Deivid21/horno-automatizado-esp32-flask/(commit log)

2026-11-11 feat(esp32): add pin and threshold configuration
2026-11-11 feat(esp32): add DHT22 sensor module
    Read chamber temperature and humidity every 2 s, keep the last valid
    reading and report a fault after repeated failed reads.
    [SensorDHT22.cpp, SensorDHT22.h]
2026-11-11 feat(esp32): add DS18B20 safety sensor module
    Non-blocking reads with an emergency at 70 C that rearms itself
    below 65 C. Disconnected or power-on readings count as faults.
2026-11-11 feat(esp32): add HC-SR04 presence module
    Detect an object inside the chamber within 10 cm, filtered over
    several consecutive readings.
2026-11-11 feat(esp32): add MQ-2 gas sensor module
    Average the analog reading, skip the 60 s warm-up and raise an
    emergency over the threshold with hysteresis.
    [SensorGas.cpp, SensorGas.h]
2026-11-11 feat(esp32): add non-blocking buzzer alarm patterns
    [Buzzer.cpp, Buzzer.h]
2026-11-11 feat(esp32): add fan and heater outputs
    The heater pin is reserved for the future optocoupler stage and
    stays low until CALEFACTOR_INSTALADO is enabled.
2026-11-11 feat(esp32): add 20x4 I2C LCD module
2026-11-11 feat(esp32): add main drying controller
    Combine the modules into a prioritized state machine with stand-by,
    15/30/60 min drying modes, automatic emergency rearm and a periodic
    serial report.
2026-11-11 docs(esp32): document wiring, states and serial commands
2026-11-11 chore(esp32): add license headers to source files
2026-11-11 feat(esp32): move LCD I2C to GPIO 21 (SDA) and 22 (SCL)
2026-11-11 feat(esp32): add JSON status line for the Flask server
    Send one JSON line after each serial report so the Raspberry Pi can
    parse the oven state over USB. Human-readable lines are unchanged.
2026-11-11 feat(flask): add oven monitor for state changes and drying cycles
    Parse the ESP32 JSON lines, log state transitions and track each
    cycle as complete or interrupted with its average temperature.
2026-11-11 feat(flask): add ESP32 serial connection
    Read the USB port in a background thread, reconnect on failure and
    send drying mode commands.
    [conexion.py]
2026-11-11 feat(flask): add demo simulator
    Generate ESP32-like data with an accelerated drying cycle to test
    the interface without hardware (HORNO_DEMO=1).
2026-11-11 feat(flask): add history charts
    Dependency-free SVG line charts so the page works offline on the
    Raspberry Pi.
2026-11-11 docs(flask): add Raspberry Pi setup guide and systemd service
2026-11-11 feat(esp32): add 5 and 45 minute drying modes
    Define the modes as a single list in config.h so new ones only need
    one change.
2026-11-11 feat(esp32): accept custom drying times
    Any whole number of minutes between 1 and 180 is accepted over
    serial; the fixed modes stay as shortcuts.
    [config.h, horno_secado.ino]
2026-11-11 feat(flask): add custom drying time input
    The dashboard keeps the fixed mode buttons and adds a field for a
    custom time, validated on both the page and the API.
    [simulador.py]
2026-11-12 feat(esp32): detect MQ-2 signal loss as a safety fault
    A powered MQ-2 reads about 48 in clean air, so a reading stuck below
    15 for 5 s means a cut wire or no power. FALLA GAS shuts the system
    down like the other safety faults and uses a triple beep.
    [Buzzer.cpp, Buzzer.h, SensorGas.cpp, SensorGas.h, config.h, horno_secado.ino]
2026-11-12 fix(esp32): hide stale sensor values during faults
    The DHT22 and DS18B20 clear their last reading once they enter a
    fault, so the LCD, serial report and JSON show --- instead of old data.
    [SensorDHT22.cpp, SensorDS18B20.cpp]
2026-11-12 feat(flask): show gas sensor fault on the dashboard
    Handle FALLA GAS as an emergency and empty the gauges when a sensor
    has no reading.
2026-11-12 feat(esp32): detect HC-SR04 failure
    A closed chamber always returns an echo from the object or the back
    wall, so 3 s without echo raises FALLA HC-SR04: heater off, cycle
    paused instead of reset, long beep every 3 s. It can be disabled with
    PRESENCIA_DETECTAR_FALLA.
    [Buzzer.cpp, Buzzer.h, SensorPresencia.cpp, SensorPresencia.h, config.h, horno_secado.ino]
2026-11-13 style(flask): adopt Material You design
    Match deivid21.github.io: tonal palette from the #00acc1 seed for
    dark and light schemes, Google Sans Flex, pill buttons and inputs,
    filled cards without borders, tonal tags and a tonal top app bar.
    The favicon follows the new color.
2026-11-13 fix(flask): close unfinished cycles and clean old readings daily
    - Mark cycles left open by a restart or power loss as interrupted on
    startup, ending them at their last reading.
    - Delete readings older than the retention period once a day instead
    of only at startup.
    - Enable SQLite WAL so dashboard reads do not wait for serial writes.
    [database.py, monitor.py]
2026-11-13 perf(flask): pause polling while the page is hidden
    Stop requesting data when the tab is hidden or the phone is locked and
    refresh right away when it comes back. Requests never overlap, and
    chart redraws on resize are batched per frame.
2026-11-13 perf(flask): track the cycle average temperature without a list
    Keep a running sum and count instead of storing every reading of the
    cycle in memory.
2026-11-13 refactor(flask): merge Material You overrides into the base styles
    Define each rule once instead of overriding the old ones at the end,
    and drop the unused .btn-ghost and .estado-nombre classes. The
    computed styles of every page are unchanged.
2026-11-13 feat(esp32): send drying limits to the Flask server
    Print the modes, custom time range, target temperature and safety
    thresholds from config.h as a JSON line at startup and every 30 s, so
    they only need to be set on the ESP32.
2026-11-13 feat(flask): use the limits sent by the ESP32
    Thresholds, target temperature and drying modes now come from the
    ESP32 instead of a copy in config.py, which only keeps defaults until
    they arrive. Pages reload once if the limits change after loading.
